Srozanovas/Pet_Tracker_V2/README.md

# Pet_Tracker_2

Pet Tracker V2. Changes from V1: 
    •Smaller size 25mm x 40mm (was 42*45)
    •LTE modem (was GSM)
    •USB support for uploading code (no USB on V1)
    •Pushbutton for powering on (was slide switch to cut off power completely)

# Changelog

## 2024-06-10 v1   
    First version of tracker. Shield and main board redesigned, decreased size.
