Srozanovas/Pet_Tracker_V2/Hardware/Main_Board/Assembly_BOM/BOM_Pet_Tracker_V2_Main_Board_v1_Main_board_PCB_v1.xlsx

No. | Quantity | Comment | Footprint | Value | Manufacturer Part | Manufacturer | Supplier Part | Supplier
1 | 1 | 1kΩ | R0603 |  | 0603WAF1001T5E | UNI-ROYAL(厚声) | C21190 | LCSC
2 | 1 | 1uF | C0603 |  | CL10A105KB8NNNC | SAMSUNG(三星) | C15849 | LCSC
3 | 1 | 10kΩ | R0603 |  | RC0603FR-0710KL | YAGEO(国巨) | C98220 | LCSC
4 | 1 | 10nF | C0603 |  | CL10B103KB8NNNC | SAMSUNG(三星) | C1589 | LCSC
5 | 1 | 15kΩ | R0603 |  | 0603WAF1502T5E | UNI-ROYAL(厚声) | C22809 | LCSC
6 | 1 | 16MHz | OSC-SMD_4P-L3.2-W2.5-BL |  | X322516MLB4SI | YXC(扬兴晶振) | C13738 | LCSC
7 | 1 | 17.8kΩ | R0603 |  | RC0603FR-0717K8L | YAGEO(国巨) | C185364 | LCSC
8 | 1 | 22.1kΩ | R0603 |  | 0603WAF2212T5E | UNI-ROYAL(厚声) | C25961 | LCSC
9 | 1 | 100Ω | R0603 |  | RC0603FR-07100RL | YAGEO(国巨) | C105588 | LCSC
10 | 1 | 120@100MHz | L0603 |  | BLM18PG121SN1D | muRata(村田) | C14709 | LCSC
11 | 1 | 560Ω | R0603 |  | 0603WAJ0561T5E | UNI-ROYAL(厚声) | C25247 | LCSC
12 | 1 | BQ21040DBVR | SOT-23-6_L2.9-W1.6-P0.95-LS2.8-BR |  | BQ21040DBVR | TI(德州仪器) | C202311 | LCSC
13 | 1 | DSHP02TSGET | SW-SMD_4P_DSHP02TSGET |  | DSHP02TSGET | YE | C40735 | LCSC
14 | 1 | GPIO | HDR-TH_4P-P2.54-V-F |  | 2.54-1*4P母 | BOOMELE(博穆精密) | C2718488 | LCSC
15 | 1 | I2C | HDR-TH_4P-P2.54-V-F |  | 2.54-1*4P母 | BOOMELE(博穆精密) | C2718488 | LCSC
16 | 1 | MT3608L | SOT-23-6_L2.9-W1.7-P0.95-LS2.8-BL |  | MT3608L | 西安航天民芯 | C2932326 | LCSC
17 | 1 | Power | HDR-TH_4P-P2.54-V-F |  | 2.54-1*4P母 | BOOMELE(博穆精密) | C2718488 | LCSC
18 | 1 | SI2301-ZE | SOT-23-3_L2.9-W1.3-P1.90-LS2.4-BR |  | SI2301-ZE | HXY MOSFET(华轩阳电子) | C5261052 | LCSC
19 | 1 | SM02B-SRSS-TB (LF)(SN) | CONN-SMD_2P-P1.00_SM02B-SRSS-TB-LF-SN |  | SM02B-SRSS-TB(LF)(SN) | JST | C160402 | LCSC
20 | 1 | SS26 | SMA_L4.3-W2.6-LS5.1-RD |  | SS26 | ElecSuper(静芯微) | C5350986 | LCSC
21 | 1 | SS26_C5350986 | SMA_L4.3-W2.6-LS5.1-RD |  | SS26 | ElecSuper(静芯微) | C5350986 | LCSC
22 | 1 | STM32F303RBT6 | LQFP-64_L10.0-W10.0-P0.50-LS12.0-BL |  | STM32F303RBT6 | ST(意法半导体) | C130453 | LCSC
23 | 1 | SWD | HEADER_1X5_1.27MM |  | 排针 1*4P | null | C59481 | LCSC
24 | 1 | TYPE-C-31-M-14 | USB-C-SMD_12P-P0.50-H-F_TYPE-C-31-M-14 |  | TYPE-C-31-M-14 | 韩国韩荣 | C223907 | LCSC
25 | 1 | UART | HDR-TH_2P-P2.54-V-F |  | 2.54-1*2P母 | BOOMELE(博穆精密) | C49661 | LCSC
26 | 1 | UART_DEBUG | HDR-TH_2P-P2.54-V-F |  | 2.54-1*2P母 | BOOMELE(博穆精密) | C49661 | LCSC
27 | 2 | 5.1kΩ | R0603 |  | 0603WAF5101T5E | UNI-ROYAL(厚声) | C23186 | LCSC
28 | 2 | 12pF | C0603 |  | CC0603JRNPO9BN120 | YAGEO(国巨) | C107034 | LCSC
29 | 2 | 22nF | C0603 |  | 0603B223K500NT | FH(风华) | C77571 | LCSC
30 | 2 | 100kΩ | R0603 |  | RC0603FR-07100KL | YAGEO(国巨) | C14675 | LCSC
31 | 2 | Mounting_Hole_PAD | MOUNTINGHOLE_2.2MM_M2_PAD
32 | 2 | MT2492 | SOT-23-6_L2.9-W1.6-P0.95-LS2.8-BL |  | MT2492 | 西安航天民芯 | C89358 | LCSC
33 | 2 | RED | LED0603-RD_RED |  | XL-1608SURC-06 | XINGLIGHT(成兴光) | C965799 | LCSC
34 | 3 | 4.7uH | IND-SMD_L4.4-W4.2 |  | BCIHP0420SC-4R7M | BC(台湾诚阳) | C2921168 | LCSC
35 | 4 | 110kΩ | R0603 |  | 0603WAF1103T5E | UNI-ROYAL(厚声) | C25805 | LCSC
36 | 6 | 22uF | C0603 |  | CL10A226MQ8NRNC | SAMSUNG(三星) | C59461 | LCSC
37 | 7 | 100nF | C0603 |  | CL10B104KB8NNNC | SAMSUNG(三星) | C1591 | LCSC
