Srozanovas/Pet_Tracker_V2/Hardware/Shield/Assembly_BOM/BOM_Board1_Shield_board_PCB_v1.xlsx

No. | Quantity | Comment | Footprint | Value | Manufacturer Part | Manufacturer | Supplier Part | Supplier
1 | 1 | 10kΩ | R0603 |  | RC0603FR-0710KL | YAGEO(国巨) | C98220 | LCSC
2 | 1 | 100uF | CAP-SMD_L3.5-W2.8-R-RD | 100uF | CA45-B-6.3V-100uF-K | CEC(振华新云) | C129289 | LCSC
3 | 1 | 470pF | C0603 | 470pF | CC0603JRNPO9BN471 | YAGEO(国巨) | C106211 | LCSC
4 | 1 | BGA2817,115 | SC-70-6_L2.0-W1.3-P0.65-LS2.1-BR |  | BGA2817,115 | NXP(恩智浦) | C2654187 | LCSC
5 | 1 | ESDA6V1W5 | SC-70-5_L2.1-W1.3-P0.65-LS2.1-BR |  | ESDA6V1W5 | ST(意法半导体) | C48677 | LCSC
6 | 1 | GPIO | HDR-TH_4P-P2.54-V-M |  | GPIO | HANBO(汉博) | C6332197 | LCSC
7 | 1 | I2C | HDR-TH_4P-P2.54-V-M |  | I2C | HANBO(汉博) | C6332197 | LCSC
8 | 1 | POWER | HDR-TH_4P-P2.54-V-M |  | POWER | HANBO(汉博) | C6332197 | LCSC
9 | 1 | SIM7080G | LCC-SMD_SIM7080G |  | SIM7080G | SIMCOM(芯讯通无线科技) | C2943992 | LCSC
10 | 1 | SM02B-SRSS-TB | CONN-SMD_2P-P1.00_SM02B-SRSS-TB-LF-SN |  | SM02B-SRSS-TB | JST | C160402 | LCSC
11 | 1 | SMN-303 | SIM-SMD_SMN-303 |  | SMN-303 | XUNPU(讯普) | C266888 | LCSC
12 | 1 | UART | HDR-TH_2P-P2.54-V-M |  | UART | XFCN(兴飞) | C492401 | LCSC
13 | 2 | 4.7kΩ | R0603 | 4.7kΩ | 0603WAF4701T5E | UNI-ROYAL(厚声) | C23162 | LCSC
14 | 2 | 100pF | C0603 | 100pF | CC0603JRNPO9BN101 | YAGEO(国巨) | C14665 | LCSC
15 | 2 | 100Ω | R0603 |  | RC0603FR-07100RL | YAGEO(国巨) | C105588 | LCSC
16 | 2 | AT24C256CDRG | SOP-8_L4.9-W3.9-P1.27-LS6.0-BL |  | AT24C256CDRG | HGC(深圳汉芯) | C19723712 | LCSC
17 | 2 | BWIPX-1-001E | IPEX-SMD_BWIPX-1-001E |  | BWIPX-1-001E | BAT WIRELESS(蝙蝠无线) | C496552 | LCSC
18 | 2 | RED | LED0603-RD_RED |  | XL-1608SURC-06 | XINGLIGHT(成兴光) | C965799 | LCSC
19 | 2 | T_P | PAD
