Srozanovas/Pet_Tracker_V2/Hardware/Main_Board/SCH_Pet_Tracker_V2_Main_Board_v1.pdf

# STM32

Decoupling | Connectors/LED

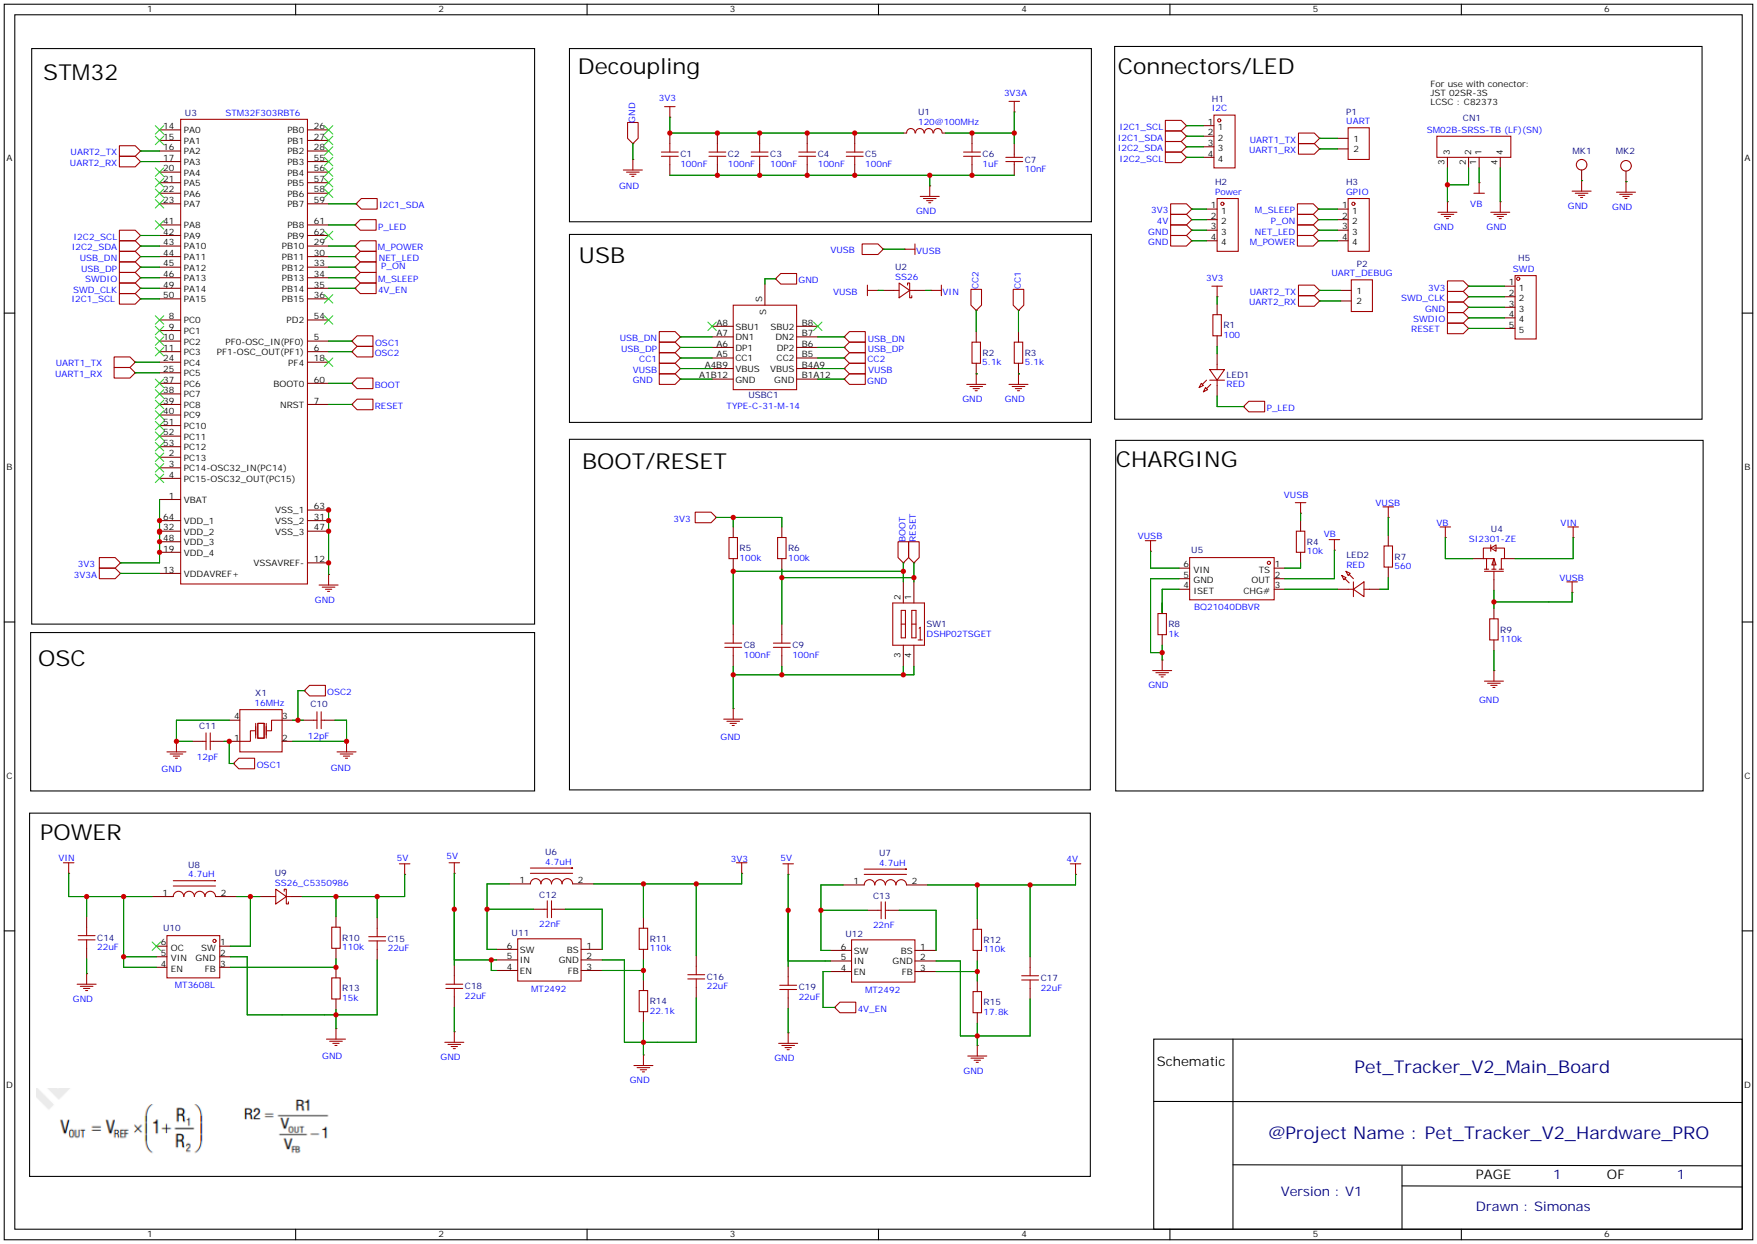
[picture p1: page 1]

SM02B-SRSS-TB (LF)(SN)
