Srozanovas/Pet_Tracker_V2/Hardware/Shield/SCH_Pet_Tracker_V2_Shield_v1.pdf

# POWER ON

# HEADERS

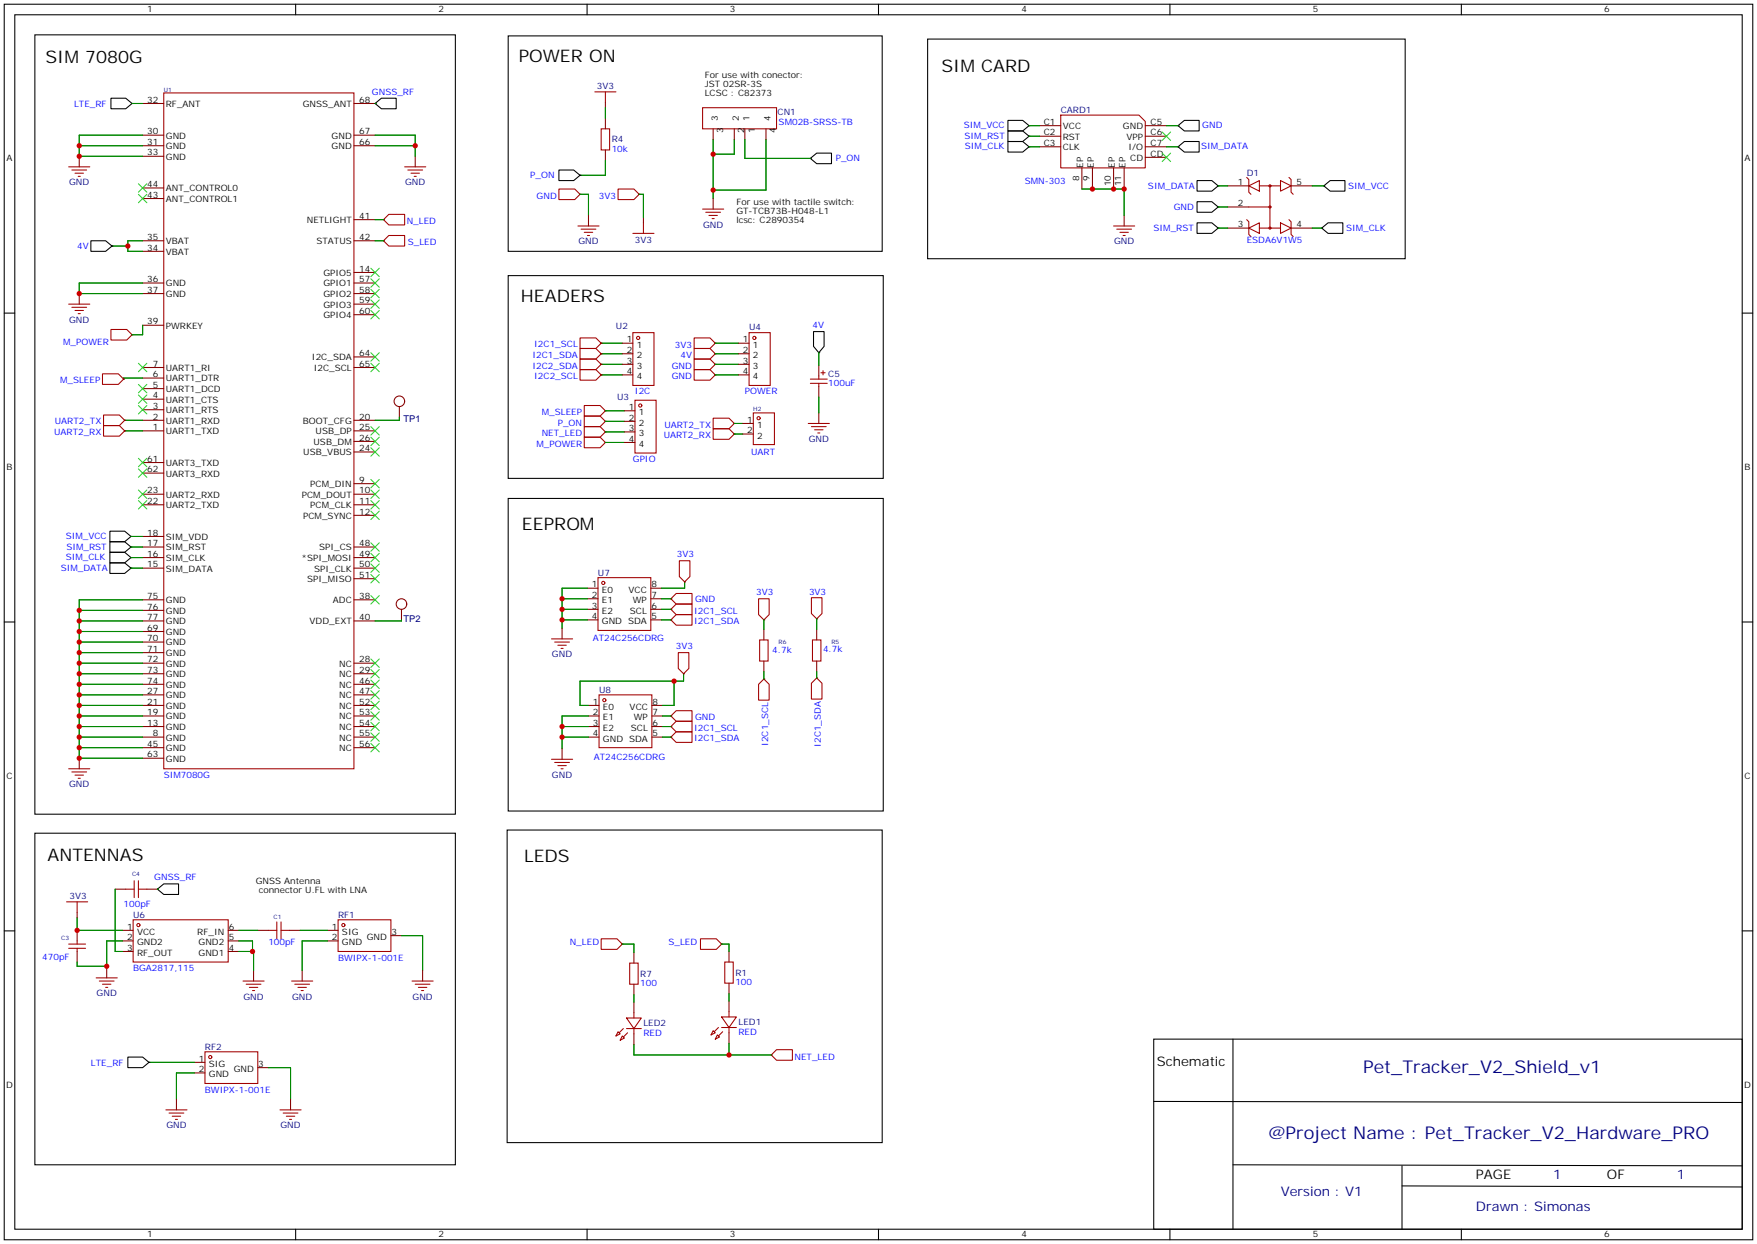
[picture p2: page 1]

For use with conector:
JST 02SR-3S
LCSC : C82373

For use with tactile switch:
GT-TCB73B-H048-L1
lcsc: C2890354

GNSS Antenna
connector U.FL with LNA
