Srozanovas/Pet_Tracker_V2/(list of files, drawings)

Other design files:
Hardware/ProProject_Pet_Tracker_V2_Hardware_PRO.epro
