Srozanovas/Pet_Tracker_V2/Software/Pet_tracker_2.ioc

Mcu.UserName=STM32F303RBTx
PA10.Signal=I2C2_SDA
PA11.Signal=USB_DM
PA12.Signal=USB_DP
PA13.Signal=SYS_JTMS-SWDIO
PA14.Signal=SYS_JTCK-SWCLK
PA15.Signal=I2C1_SCL
PA2.Signal=USART2_TX
PA3.Signal=USART2_RX
PA9.Signal=I2C2_SCL
PB7.Signal=I2C1_SDA
PC4.Signal=USART1_TX
PC5.Signal=USART1_RX
PF0-OSC_IN.Signal=RCC_OSC_IN
PF1-OSC_OUT.Signal=RCC_OSC_OUT
